keiyinau/FFC_LEMO/LEMOAdaptorBoard7_Compact_RevB/Copper_Plates_FFC_only/README.txt

Latest copper plate option: Plate Rev C for Compact PCB Rev B.
Upper plate has ONLY the right-hand FFC cutout (16 x 67 mm). Left side is uncut.
Lower plate, external size 65 x 125 x 2 mm, and four diameter 3.4 mm holes are unchanged.
Hole centres from lower-left: (5,6), (60,6), (5,119), (60,119) mm.
Right cutout X49..65, Y18..85 mm from lower-left; 40..107 mm down from top.
STEP files are local manufacturing coordinates. FCStd uses provisional 25/8 mm upper/lower gaps.
PCB electrical design is unchanged. The older PCB Dwgs.User layer still shows the superseded two-cutout proposal; use this PDF/STEP for plate geometry.
Physical access and shell clearance are not validated. Keep plate isolated from SGND shells and live conductors.
