keiyinau/FFC_LEMO/LEMOAdaptorBoard7_Compact_RevB/review/front.png

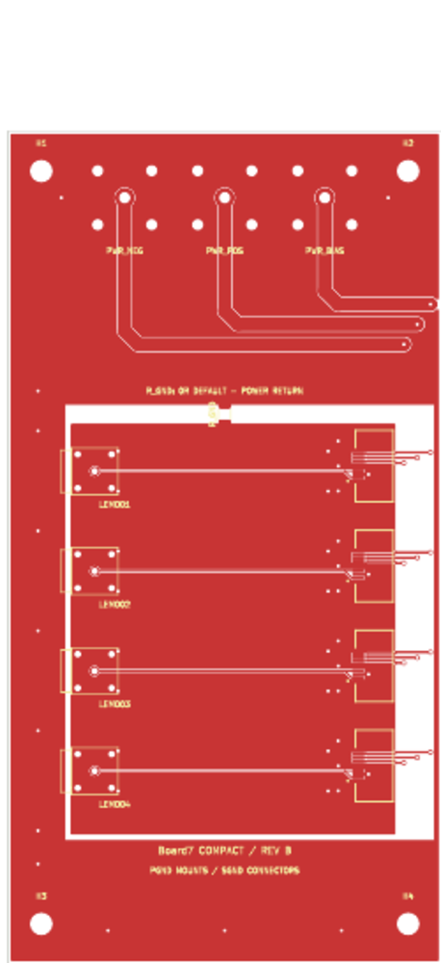
LEMOAdaptorBoard7_Compact_RevB/review/front.png
