keiyinau/FFC_LEMO/LEMOAdaptorBoard7_Compact_RevB/Assembly/BOM_FFC_BNC.csv

Comment | Designator | Footprint | LCSC Part # | Quantity
ZF5S-10-01-T-WT-K-TR | FFC1,FFC2,FFC3,FFC4 | Samtec_ZF5S_10P_0.5mm_Horizontal | C5366376 | 4
BNC-KWE-6 | PWR_NEG,PWR_POS,PWR_BIAS | BNC_KWE_6_8.1mm_5holes_1.5mm | C20415789 | 3
