keiyinau/FFC_LEMO/ShieldingBox/Board6_ShieldingBox_Assembly.step

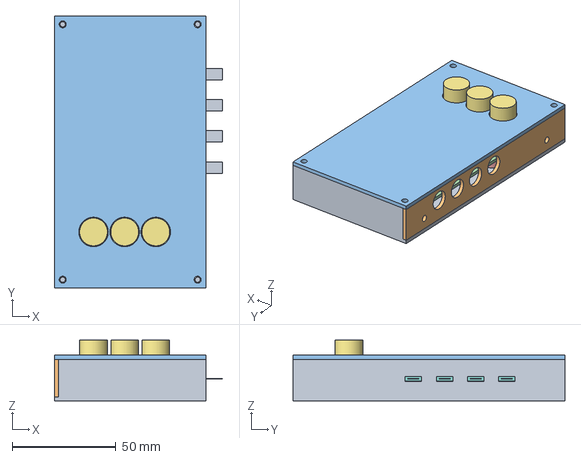
[picture p2: CAD file, 2026-10-28]
ShieldingBox/Board6_ShieldingBox_Assembly.step
81.0 x 131.0 x 29.3 mm
