keiyinau/FFC_LEMO/ShieldingBox/Lid.step

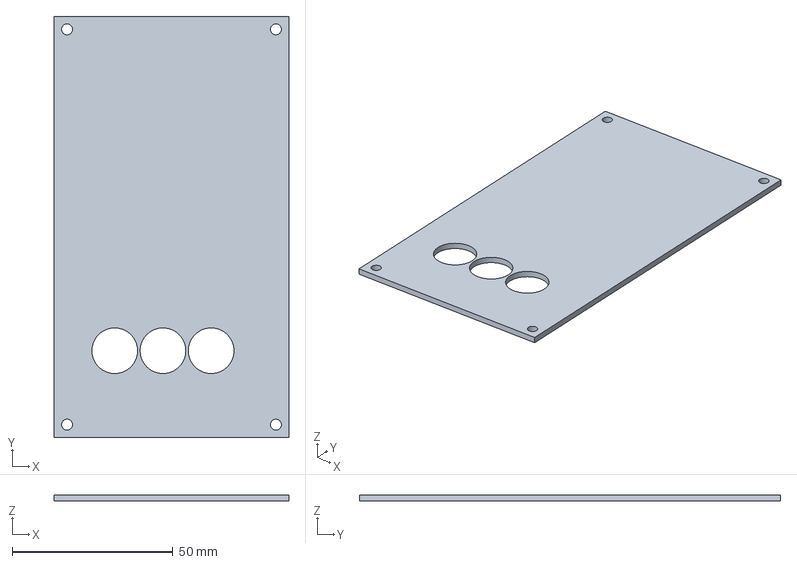
[picture p5: CAD file, 2026-10-28]
ShieldingBox/Lid.step
73.0 x 131.0 x 2.00 mm
