keiyinau/FFC_LEMO/LEMOAdaptorBoard7_Compact_RevB/Copper_Plates_FFC_only/Upper_Plate.step

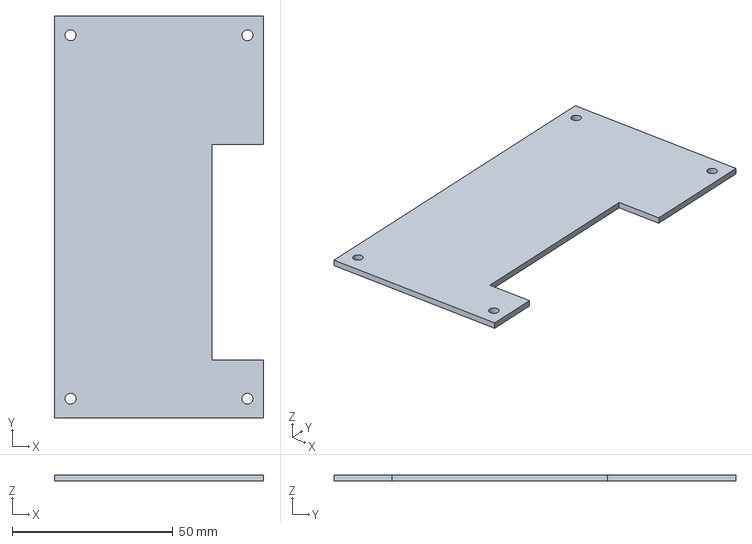
[picture p6: CAD file, 2026-11-04]
LEMOAdaptorBoard7_Compact_RevB/Copper_Plates_FFC_only/Upper_Plate.step
65.0 x 125.0 x 2.00 mm
