keiyinau/FFC_LEMO/ShieldingBox/BaseTray.step

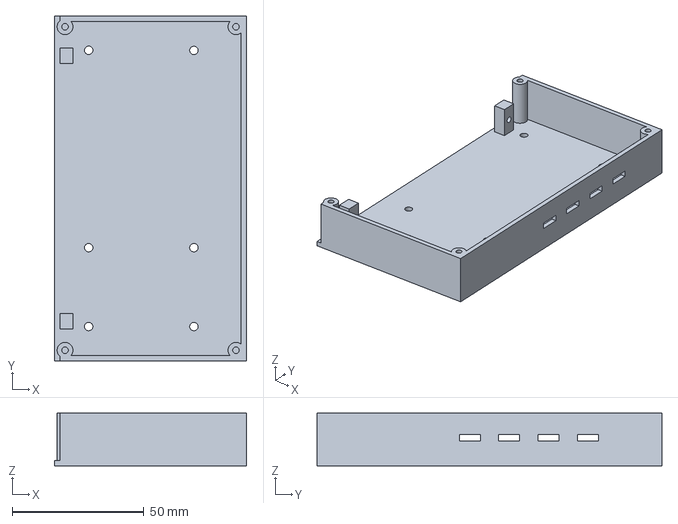
[picture p7: CAD file, 2026-10-28]
ShieldingBox/BaseTray.step
73.0 x 131.0 x 20.0 mm
