keiyinau/FFC_LEMO/LEMOAdaptorBoard7_Compact_RevB/Copper_Plates/Compact_Sandwich.FCStd

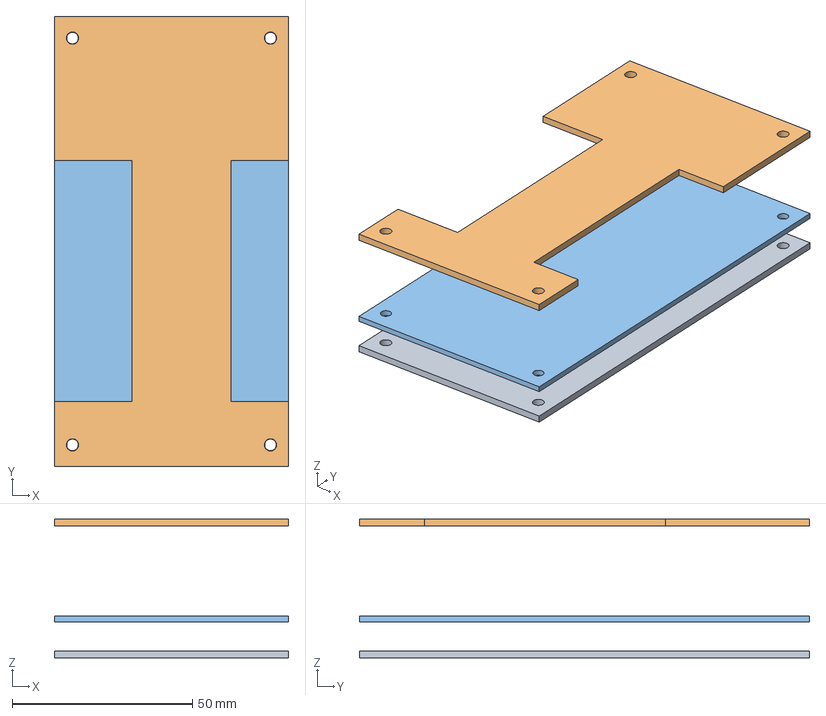
[picture p8: CAD file, 2026-11-04]
LEMOAdaptorBoard7_Compact_RevB/Copper_Plates/Compact_Sandwich.FCStd
65.0 x 125.0 x 38.6 mm
Lower_Plate
Upper_Plate
PCB_envelope
