keiyinau/FFC_LEMO/ShieldingBox/LEMOAccessPlate.step

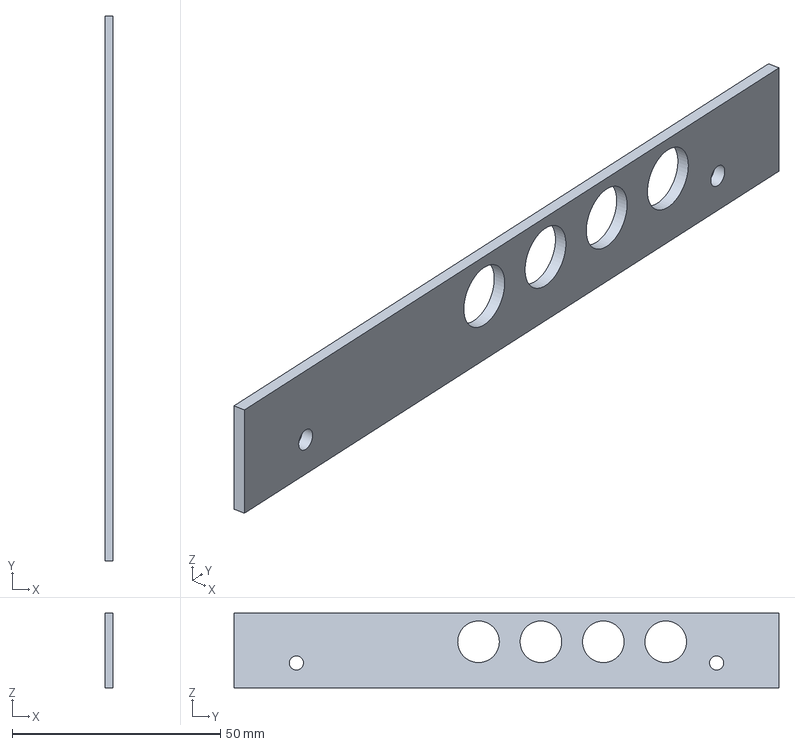
[picture p10: CAD file, 2026-10-28]
ShieldingBox/LEMOAccessPlate.step
2.00 x 131.0 x 18.0 mm
