keiyinau/FFC_LEMO/(list of files, cad)

Other CAD files:
LEMOAdaptorBoard7_Compact_RevB/Copper_Plates/Lower_Plate.step
