keiyinau/FFC_LEMO/LEMOAdaptorBoard7_Compact_RevB/Copper_Plates/Copper_Plates_Drawing.pdf

# Board7 Compact Rev B - Lower copper plate

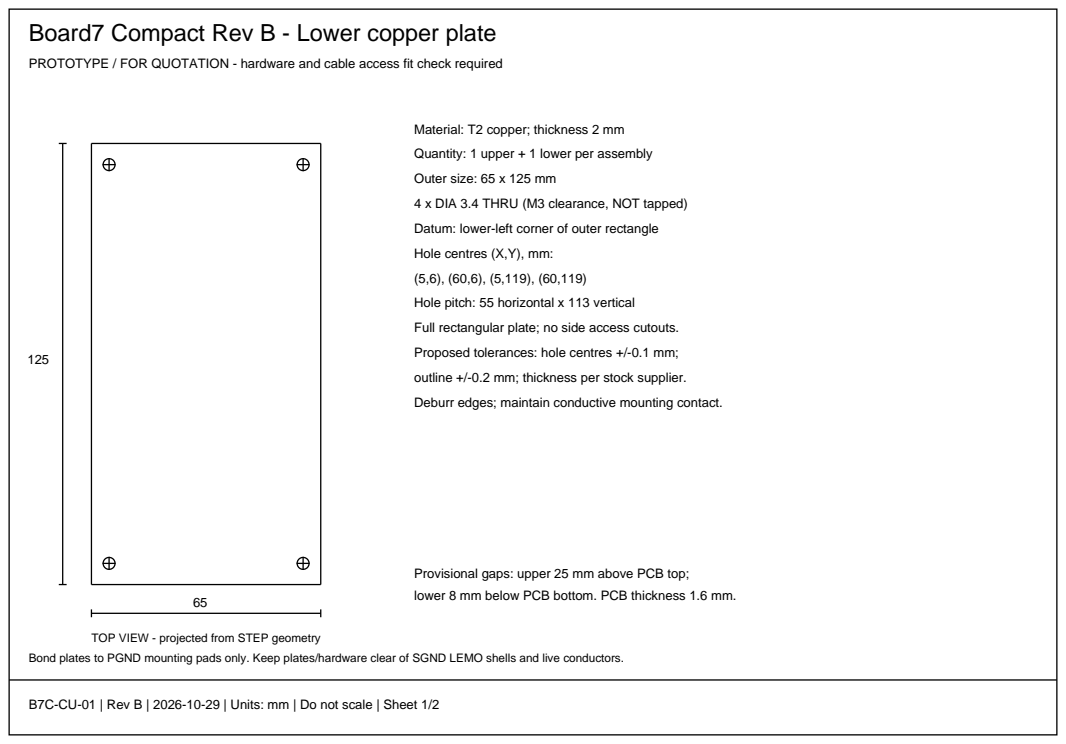
[picture p11: page 1]

PROTOTYPE / FOR QUOTATION - hardware and cable access fit check required

Material: T2 copper; thickness 2 mm
Quantity: 1 upper + 1 lower per assembly
Outer size: 65 x 125 mm
4 x DIA 3.4 THRU (M3 clearance, NOT tapped)
Datum: lower-left corner of outer rectangle
Hole centres (X,Y), mm:
Hole pitch: 55 horizontal x 113 vertical
Full rectangular plate; no side access cutouts.
Proposed tolerances: hole centres +/-0.1 mm;
outline +/-0.2 mm; thickness per stock supplier.
Deburr edges; maintain conductive mounting contact.

Provisional gaps: upper 25 mm above PCB top;
lower 8 mm below PCB bottom. PCB thickness 1.6 mm.

TOP VIEW - projected from STEP geometry

Bond plates to PGND mounting pads only. Keep plates/hardware clear of SGND LEMO shells and live conductors.

B7C-CU-01 | Rev B | 2026-10-29 | Units: mm | Do not scale | Sheet 1/2

# Board7 Compact Rev B - Upper copper plate

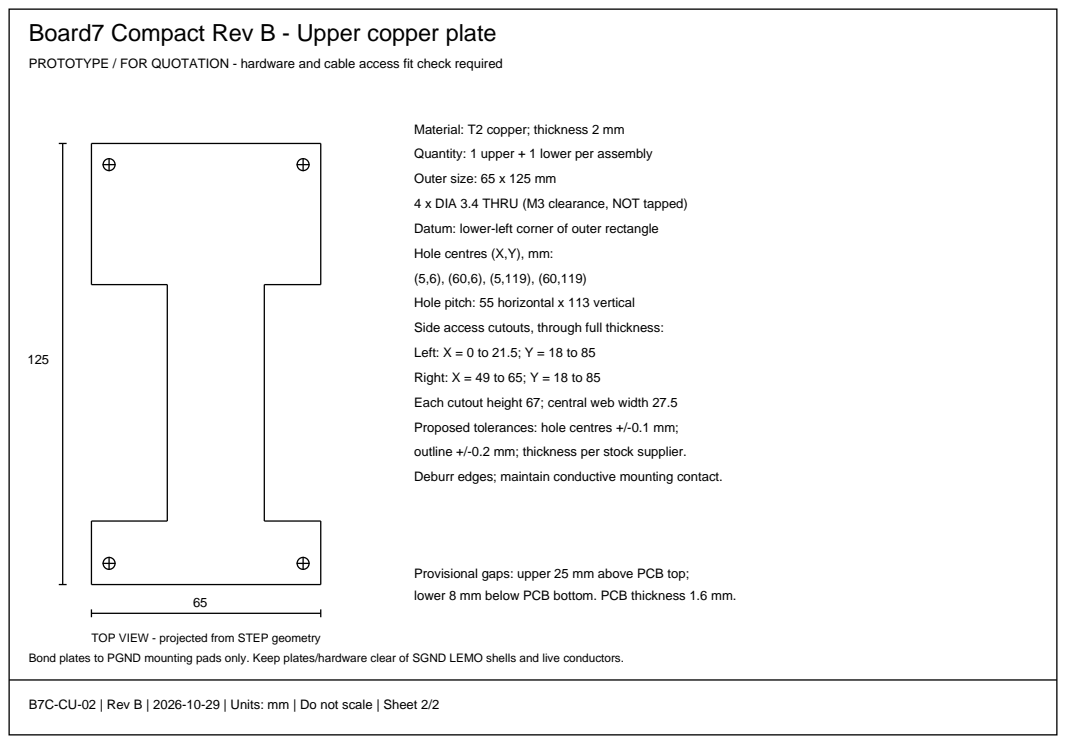
[picture p12: page 2]

PROTOTYPE / FOR QUOTATION - hardware and cable access fit check required

Material: T2 copper; thickness 2 mm
Quantity: 1 upper + 1 lower per assembly
Outer size: 65 x 125 mm
4 x DIA 3.4 THRU (M3 clearance, NOT tapped)
Datum: lower-left corner of outer rectangle
Hole centres (X,Y), mm:
Hole pitch: 55 horizontal x 113 vertical
Side access cutouts, through full thickness:
Left: X = 0 to 21.5; Y = 18 to 85
Right: X = 49 to 65; Y = 18 to 85
Each cutout height 67; central web width 27.5
Proposed tolerances: hole centres +/-0.1 mm;
outline +/-0.2 mm; thickness per stock supplier.
Deburr edges; maintain conductive mounting contact.

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

TOP VIEW - projected from STEP geometry

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

B7C-CU-02 | Rev B | 2026-10-29 | Units: mm | Do not scale | Sheet 2/2
