keiyinau/FFC_LEMO/LEMOAdaptorBoard7_Compact_RevB/LEMOAdaptorBoard7.kicad_pcb

## KiCad design LEMOAdaptorBoard7_Compact_RevB/LEMOAdaptorBoard7.kicad_pcb (2026-11-04)

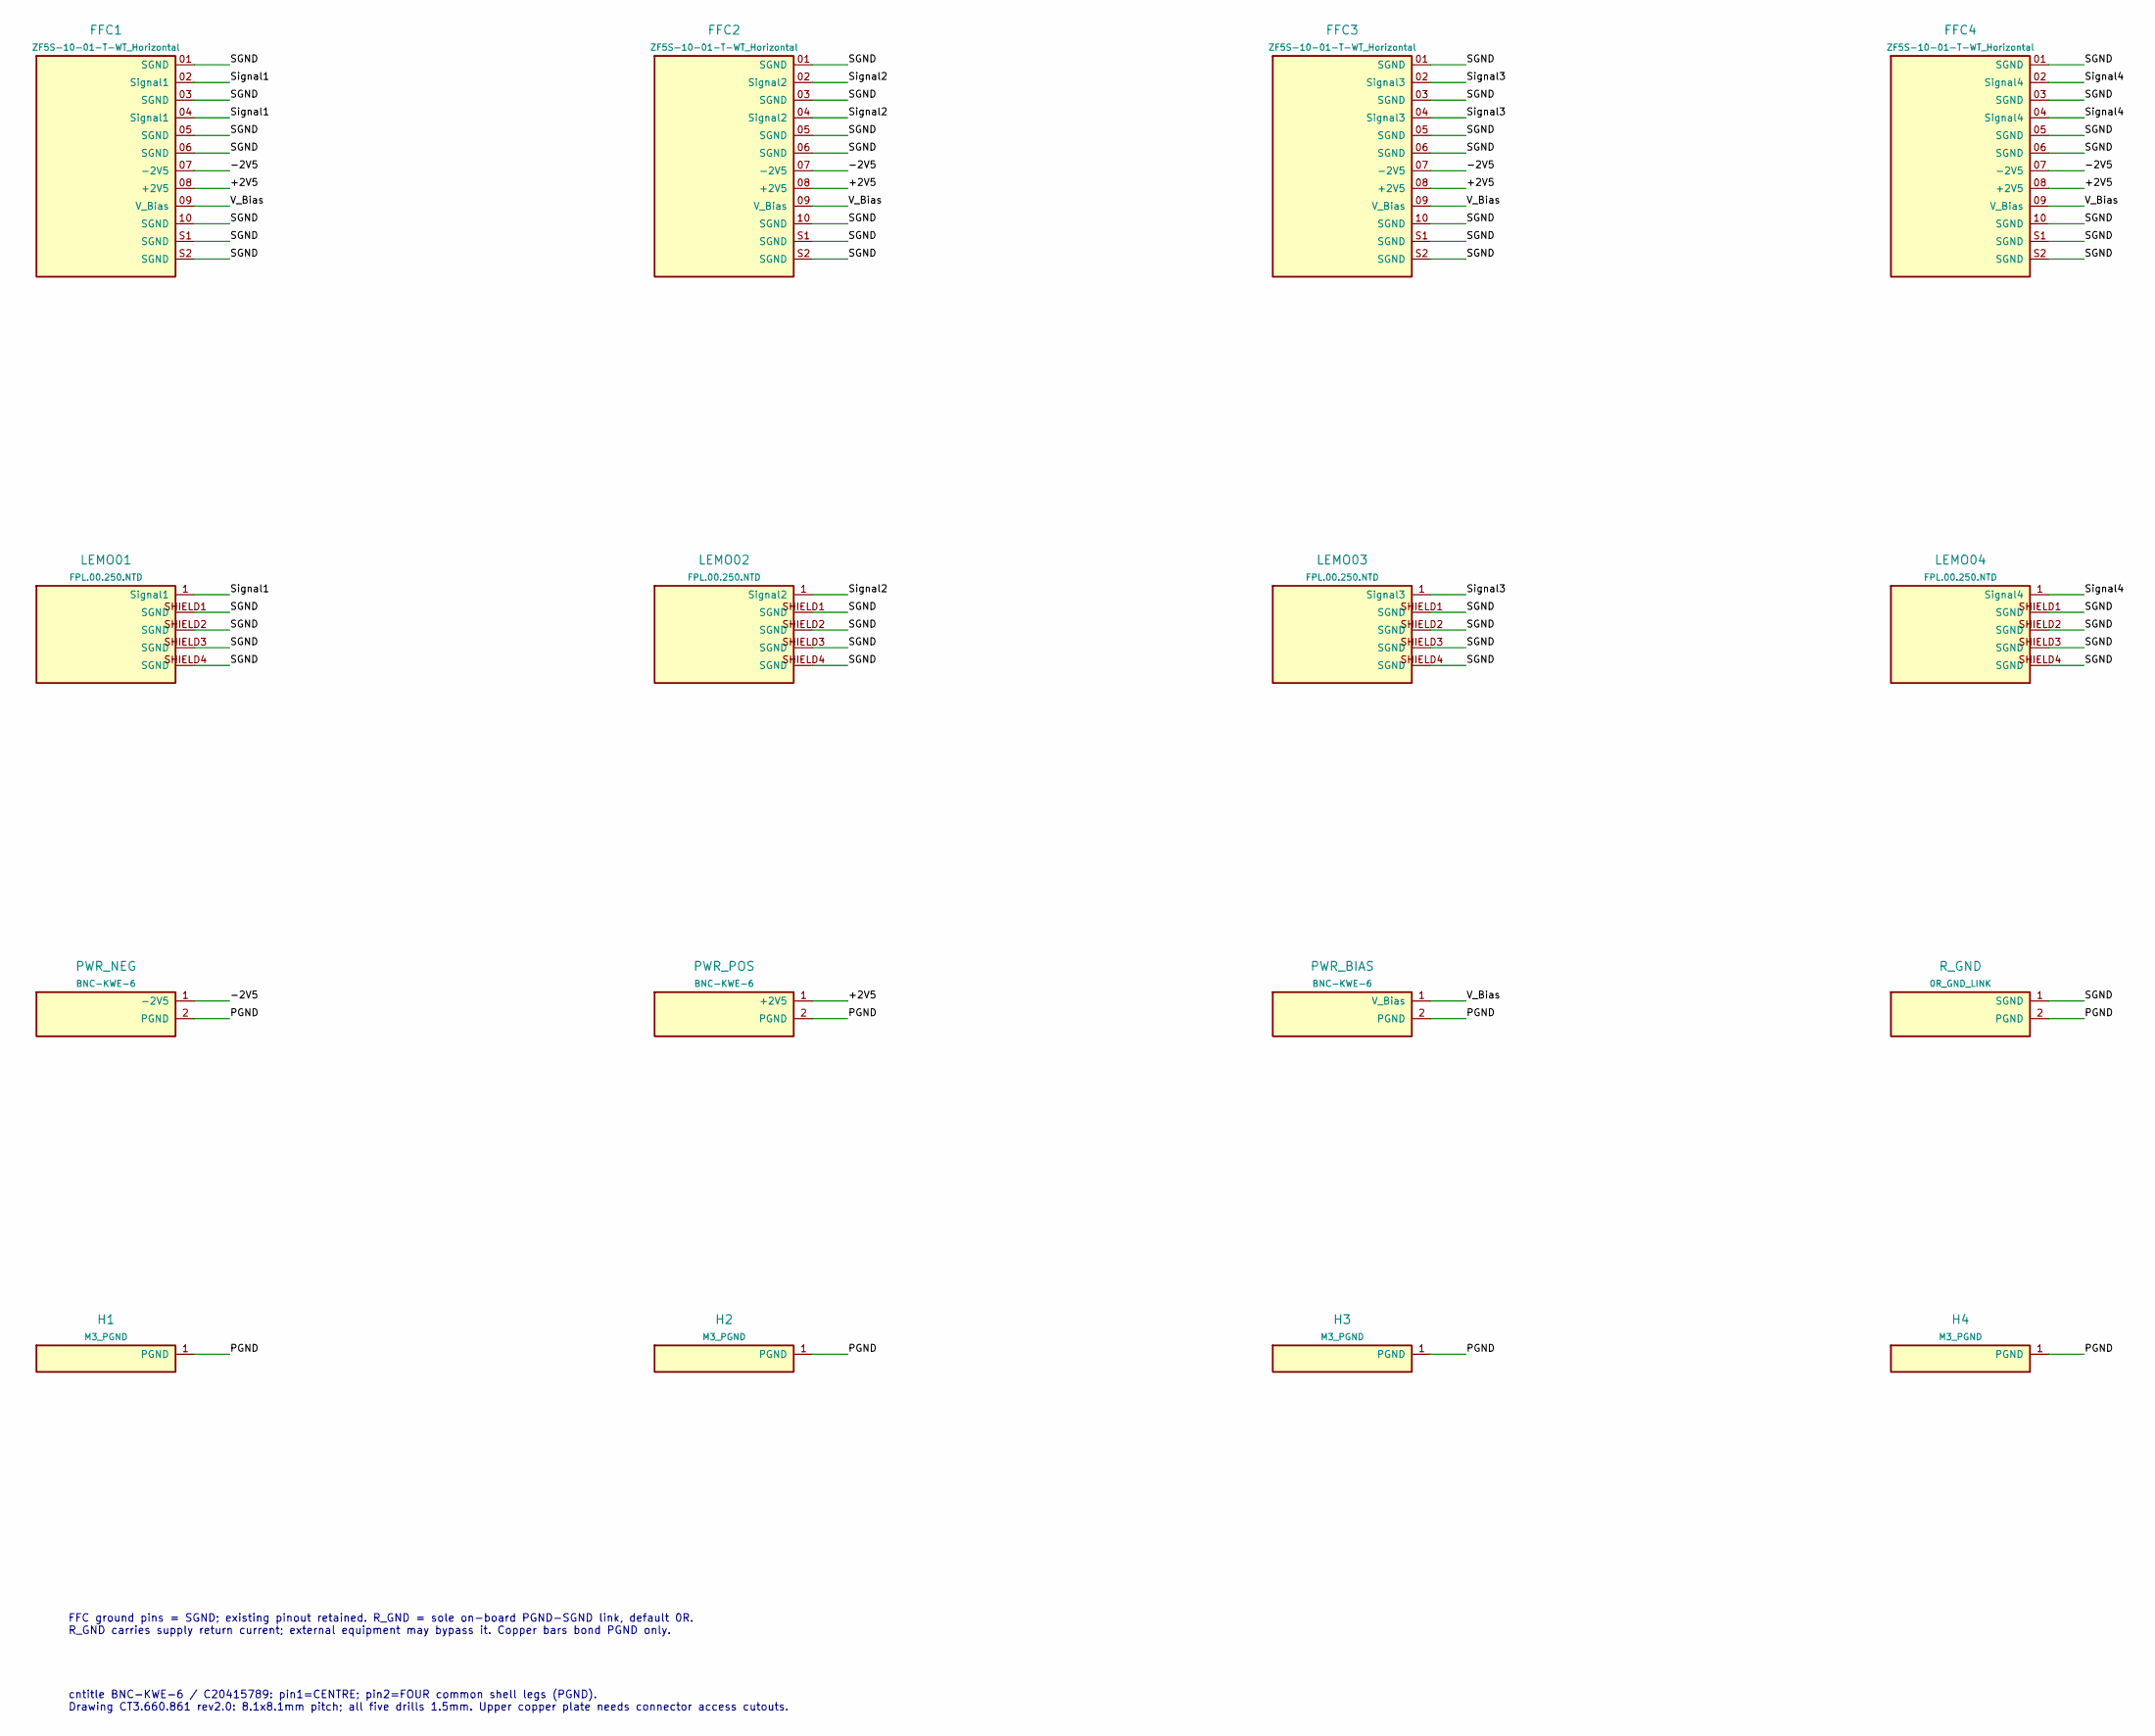
[picture p15: schematic LEMOAdaptorBoard7.kicad_sch, Board7 Compact - PGND / SGND]

Parts:
FFC1: ZF5S-10-01-T-WT_Horizontal; FFC1
FFC2: ZF5S-10-01-T-WT_Horizontal; FFC2
FFC3: ZF5S-10-01-T-WT_Horizontal; FFC3
FFC4: ZF5S-10-01-T-WT_Horizontal; FFC4
H1: M3_PGND; H1
H2: M3_PGND; H2
H3: M3_PGND; H3
H4: M3_PGND; H4
LEMO01: FPL.00.250.NTD; LEMO01
LEMO02: FPL.00.250.NTD; LEMO02
LEMO03: FPL.00.250.NTD; LEMO03
LEMO04: FPL.00.250.NTD; LEMO04
PWR_BIAS: BNC-KWE-6; PWR_BIAS
PWR_NEG: BNC-KWE-6; PWR_NEG
PWR_POS: BNC-KWE-6; PWR_POS
R_GND: 0R_GND_LINK; R_GND

Connections:
/+2V5: FFC1.08 (+2V5), FFC2.08 (+2V5), FFC3.08 (+2V5), FFC4.08 (+2V5), PWR_POS.1 (+2V5)
/-2V5: FFC1.07 (-2V5), FFC2.07 (-2V5), FFC3.07 (-2V5), FFC4.07 (-2V5), PWR_NEG.1 (-2V5)
/PGND: H1.1, H2.1, H3.1, H4.1, PWR_BIAS.2 (PGND), PWR_NEG.2 (PGND), PWR_POS.2 (PGND), R_GND.2 (PGND)
/SGND: FFC1.01 (Earth), FFC1.03 (Earth), FFC1.05 (Earth), FFC1.06 (Earth), FFC1.10 (Earth), FFC1.S1 (MP1), FFC1.S2 (MP2), FFC2.01 (Earth), FFC2.03 (Earth), FFC2.05 (Earth), FFC2.06 (Earth), FFC2.10 (Earth), FFC2.S1 (MP1), FFC2.S2 (MP2), FFC3.01 (Earth), FFC3.03 (Earth), FFC3.05 (Earth), FFC3.06 (Earth), FFC3.10 (Earth), FFC3.S1 (MP1), FFC3.S2 (MP2), FFC4.01 (Earth), FFC4.03 (Earth), FFC4.05 (Earth), FFC4.06 (Earth), FFC4.10 (Earth), FFC4.S1 (MP1), FFC4.S2 (MP2), LEMO01.SHIELD1 (SGND), LEMO01.SHIELD2 (SGND), LEMO01.SHIELD3 (SGND), LEMO01.SHIELD4 (SGND), LEMO02.SHIELD1 (SGND), LEMO02.SHIELD2 (SGND), LEMO02.SHIELD3 (SGND), LEMO02.SHIELD4 (SGND), LEMO03.SHIELD1 (SGND), LEMO03.SHIELD2 (SGND), LEMO03.SHIELD3 (SGND), LEMO03.SHIELD4 (SGND), LEMO04.SHIELD1 (SGND), LEMO04.SHIELD2 (SGND), LEMO04.SHIELD3 (SGND), LEMO04.SHIELD4 (SGND), R_GND.1 (SGND)
/Signal1: FFC1.02 (Signal), FFC1.04 (Signal), LEMO01.1 (Signal1)
/Signal2: FFC2.02 (Signal), FFC2.04 (Signal), LEMO02.1 (Signal2)
/Signal3: FFC3.02 (Signal), FFC3.04 (Signal), LEMO03.1 (Signal3)
/Signal4: FFC4.02 (Signal), FFC4.04 (Signal), LEMO04.1 (Signal4)
/V_Bias: FFC1.09 (V_Bias), FFC2.09 (V_Bias), FFC3.09 (V_Bias), FFC4.09 (V_Bias), PWR_BIAS.1 (V_Bias)

Notes on the sheet:
FFC ground pins = SGND; existing pinout retained. R_GND = sole on-board PGND-SGND link, default 0R. R_GND carries supply return current; external equipment may bypass it. Copper bars bond PGND only.
cntitle BNC-KWE-6 / C20415789: pin1=CENTRE; pin2=FOUR common shell legs (PGND). Drawing CT3.660.861 rev2.0: 8.1x8.1mm pitch; all five drills 1.5mm. Upper copper plate needs connector access cutouts.

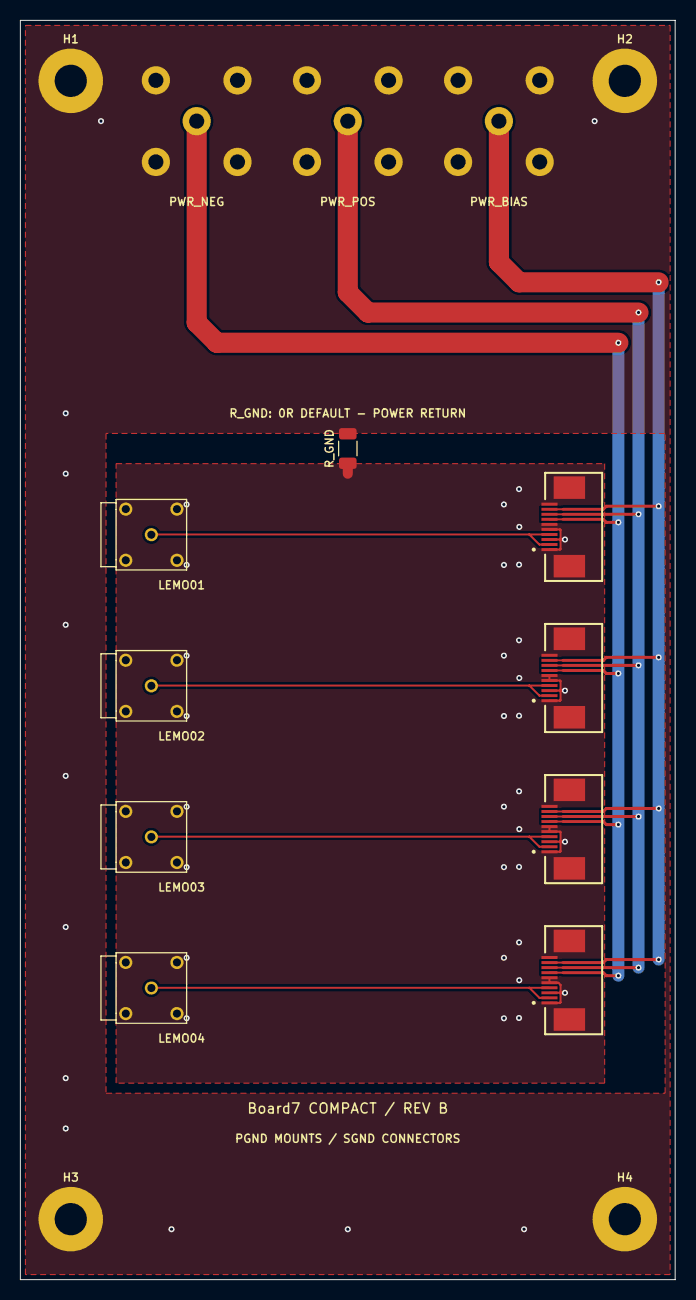
[picture p16: board LEMOAdaptorBoard7.kicad_pcb from above]

Board: 2 copper layers, 65.0 x 125.0 mm, 16 parts (0 on the bottom side), 9 nets.
